mldelibero/roboCooler/README.md

# roboCooler

The compiler used is Keil UV5, which can be downloaded at: 
https://www.keil.com/demo/eval/arm.htm

This project is targeted at the STM32F4DISCOVERY developement kit.
http://www.st.com/web/catalog/tools/FM116/CL1620/SC959/SS1532/LN1848/PF252419?s_searchtype=partnumber

You can find the USB driver for the board there if it doesn't install automatically.

In order to compile the code, open up Keil and press F7 or click Project->Build Target

In order to download the code to the board click Flash->Download
