mldelibero/roboCooler/dwg/roboCoolerBOM.xlsx

Item | Mfg | Mfg P/N | Description | RefDes | Qnty | Vendor | Vendor P/N | Cost | Total Cost | $51.80
1 | Panasonic | EEE-1EA101XP | 100µF Aluminum Capacitor Polar 25V Surface Mount Radial, Can - SMD ±20% -40°C ~ 85°C | C1-C4 | 4 | Digikey | PCE3898TR-ND | $0.12 | $0.48
2 | TDK | C2012X7R2A103K085AA | 10000pF ±10% 100V X7R Ceramic Capacitor -55°C ~ 125°C Surface Mount, MLCC 0805 (2012 Metric) 0.079" L x 0.049" W (2.00mm x 1.25mm) | C5 C6 C17 C18 | 4 | Digikey | 445-1343-1-ND | 0.11 | $0.44
3 | TDK | C2012X7R2A104K125AA | 0.10µF ±10% 100V X7R Ceramic Capacitor -55°C ~ 125°C Surface Mount, MLCC 0805 (2012 Metric) 0.079" L x 0.049" W (2.00mm x 1.25mm) | C8 | 1 | Digikey | 445-1418-1-ND | 0.18 | $0.18
4 | TDK | C2012X7R1E105K125AB | 1µF ±10% 25V X7R Ceramic Capacitor -55°C ~ 125°C Surface Mount, MLCC 0805 (2012 Metric) 0.079" L x 0.049" W (2.00mm x 1.25mm) | C9 C10 C19 | 3 | Digikey | 445-1354-1-ND | 0.14 | $0.42
5 | TDK | C2012X7R1E224M | 0.22µF ±20% 25V X7R Ceramic Capacitor -55°C ~ 125°C Surface Mount, MLCC 0805 (2012 Metric) 0.079" L x 0.049" W (2.00mm x 1.25mm) | C13-C15 | 3 | Digikey | 445-7561-1-ND | 0.14 | $0.42
6 | TDK | C2012X5R1E106K125AB | 10µF ±10% 25V X5R Ceramic Capacitor -55°C ~ 85°C Surface Mount, MLCC 0805 (2012 Metric) 0.079" L x 0.049" W (2.00mm x 1.25mm) | C16 | 1 | Digikey | 445-5984-1-ND | 0.35 | $0.35
7 | Micro Commercial | BAT42W-TP | DIODE SCHOTTKY 30V 200MA SOD123 | D1 D2 | 2 | Digikey | BAT42WTPMSCT-ND (http://www.digikey.com/product-search/en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) | $0.40 | $0.80
8 | Keystone | 3568 | Fuse Holder | F1 F2 | 2 | Digikey | 36-3568-ND | $0.98 | $1.96
9 | LittleFuse | 0297004.WXNV | 4A Fuse Mini-ATO | F1 F2 | 2 | Digikey | F988-ND | $0.47 | $0.94
10 | On Shore Tech | EDZ950/2 | 2 Position Terminal Block Plug, Female Sockets 0.200" (5.08mm) 180° Free Hanging (In-Line) | J1 J2 | 2 | Digikey | ED1717-ND | $1.34 | $2.68
11 | On Shore Tech | EDSTLZ950/2 | 2 Position Terminal Block Header, Male Pins, Shrouded (4 Side) 0.200" (5.08mm) 90°, Right Angle Through Hole | J1 J2 | 2 | Digikey | ED1817-ND | $0.55 | $1.10
12 | 3M | SFH11-PBPC-D25-ST-BK | 50 Position Header Connector 0.100" (2.54mm) Through Hole Gold | J3 J6 | 2 | Digikey | S9201-ND (http://www.digikey.com/product-search/en?x=-787&y=-73&lang=en&site=us&KeyWords=S9201-ND) | $2.89 | $5.78
13 | Sullins | PPPC061LFBN-RC | 6 Position Header Connector 0.100" (2.54mm) Through Hole Gold | J4 | 1 | Digikey | S7039-ND | 0.7 | $0.70
14 | Sullins | PPPC121LFBN-RC | 12 Position Header Connector 0.100" (2.54mm) Through Hole Gold | J5 | 1 | Digikey | S7045-ND | 1.01 | $1.01
15 | Molex | 901303206 | 6 Positions Header, Shrouded Connector 0.100" (2.54mm) Through Hole, Right Angle Gold | J7 J8 J10 J11 J13 J14 | 6 | Digikey | WM8275-ND (http://www.digikey.com/product-detail/en/molex-llc/0901303206/WM8275-ND/760987) | 1.55 | $9.30
16 | Molex | 901420006 | CONN HOUSING 6POS .100" DUAL | P7 P8 P10 P11 P13 P14 | 6 | Digikey | WM8035-ND | 0.43 | $2.58
17 | Molex | 901190110 | Socket Contact Gold 22-24 AWG Crimp | P7 P8 P10 P11 P13 P14 | 36 | Digikey | WM2580CT-ND | 0.22 | $7.92
18 | Assmann | AU-Y1005 | USB Connector | J12 | 1 | Digikey | AE11181-ND | $0.63 | $0.63
19 | Panasonic | ERJ-6ENF1002V | RES SMD 10K OHM 1% 1/8W 0805 | R1 R2 R8-R11 | 6 | Digikey | P10.0KCCT-ND | $0.10 | $0.60
20 | Panasonic | ERJ-6ENF1001V | RES SMD 1K OHM 1% 1/8W 0805 | R5-R7 | 3 | Digikey | P1.00KCCT-ND | $0.10 | $0.30
21 | Fairchild | FDD8878 | MOSFET N-CH 30V 40A DPAK | Q1 Q2 | 2 | Digikey | FDD8878CT-ND | $0.78 | $1.56
22 | Ti | SN74LVC1G04QDBVRQ1 | IC SINGLE INVERTER GATE SOT23-5 | U1 | 1 | Digikey | 296-26588-1-ND (http://www.digikey.com/product-search/en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) | $0.49 | $0.49
23 | Toshiba | TB6549FG(O,EL) | IC MOTOR DRIVER PAR 20HSOP | U2 | 1 | Digikey | TB6549FGOELCT-ND | $4.33 | $4.33
24 | E-Switch | TL3342F160QG/TR | SWITCH TACTILE SPST-NO 0.05A 12V |  | 1 | Digikey | EG2531CT-ND | $0.63 | $0.63
25 | 5V Switcher | OKY-T/3-D12N-C | Non-Isolated PoL Module DC DC Converter 1 Output 0.75 ~ 5.5 V 3A 8.3V - 14V Input | U4 | 1 | Digikey | 811-1990-1-ND | $6.20 | $6.20
