mldelibero/roboCooler/dwg/roboCooler.kicad_pcb

## KiCad design dwg/roboCooler.kicad_pcb (2017-06-04)

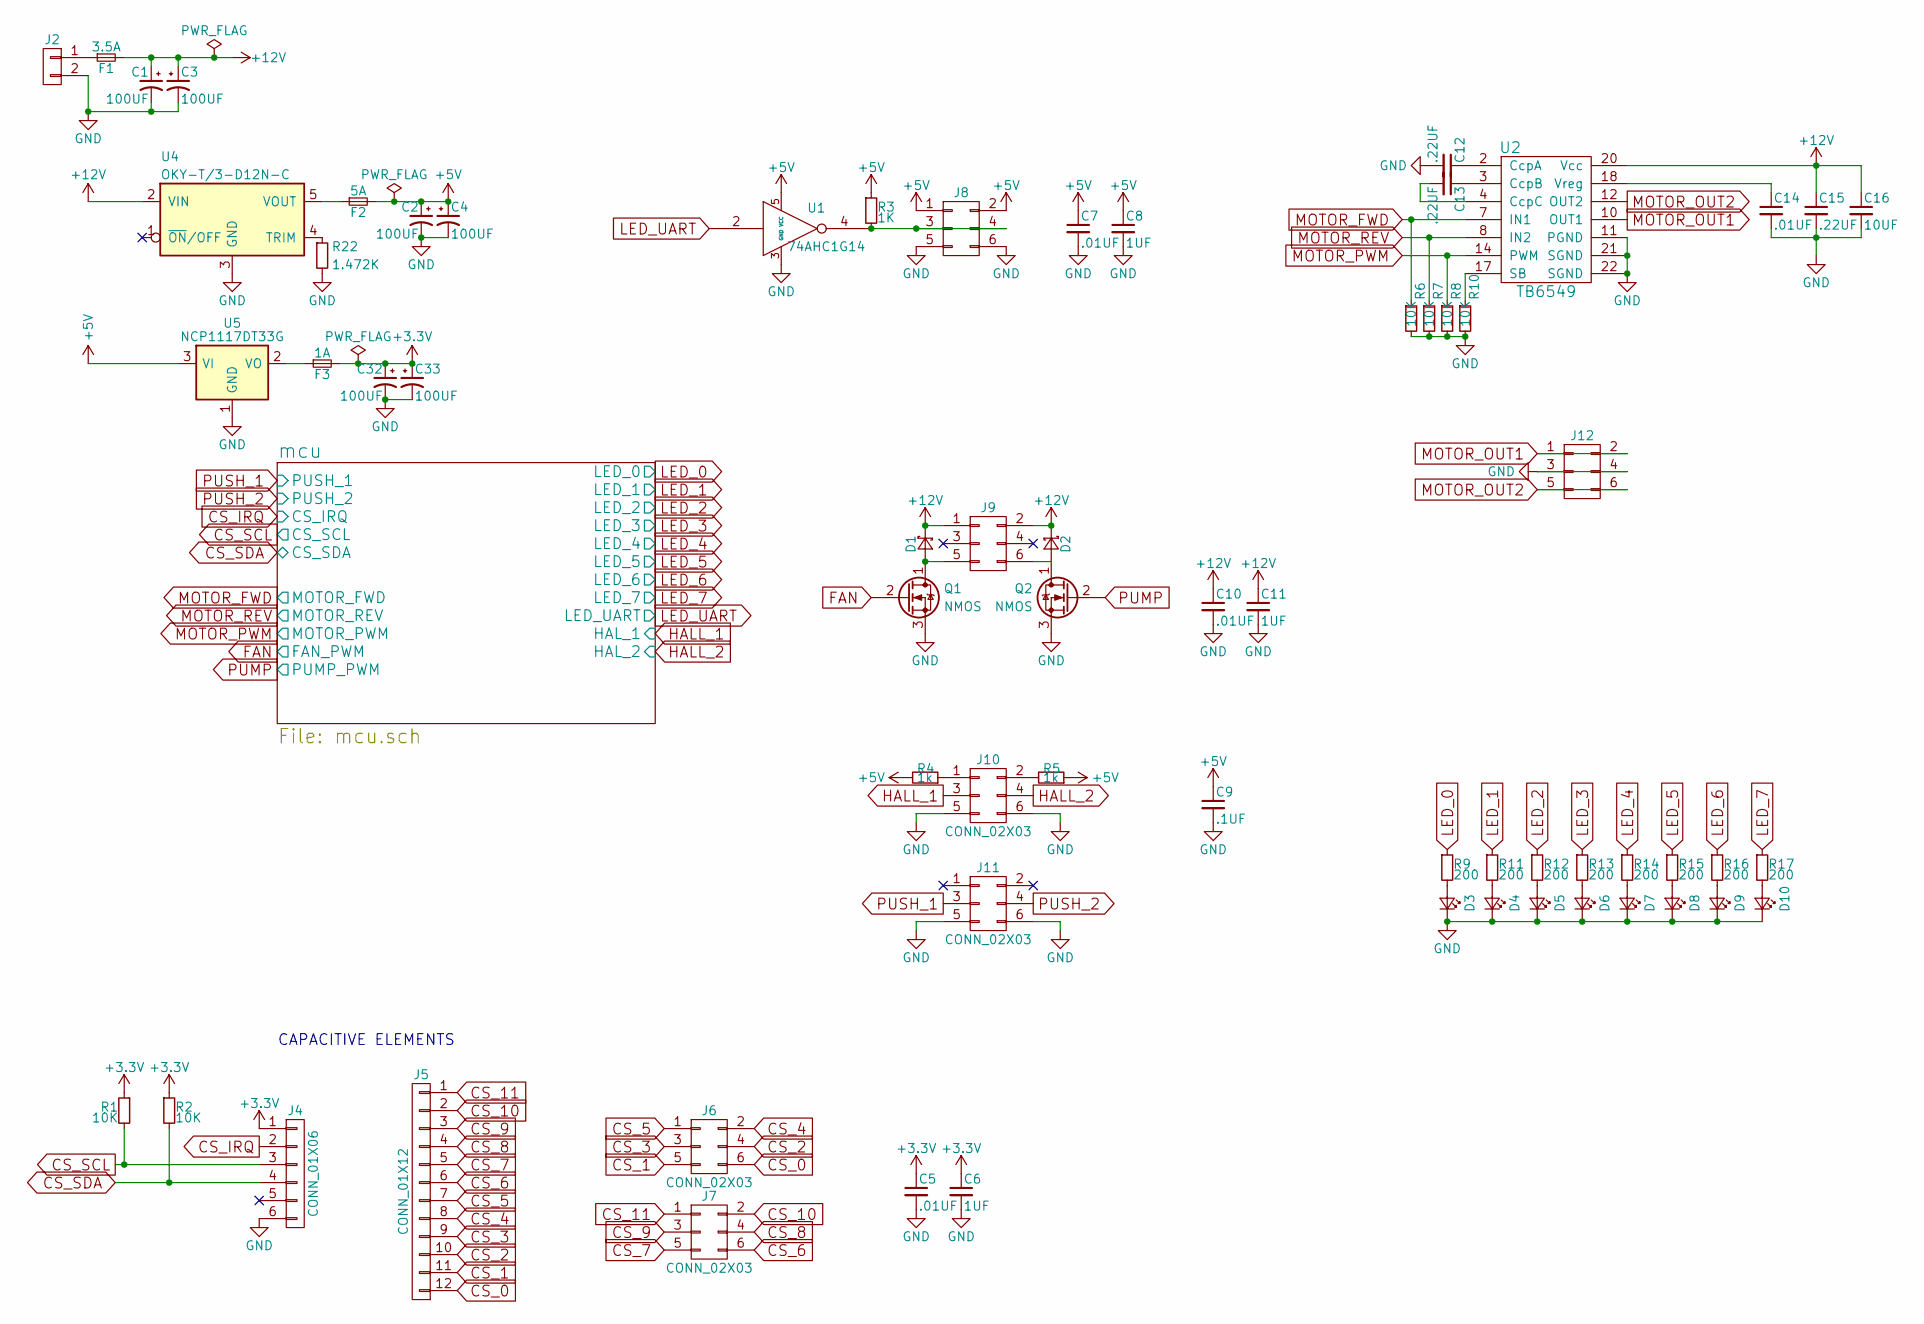
[picture p1: schematic roboCooler.sch]

Parts:
C1, C2, C3, C4, C32, C33: 100UF; c_elec_6.6x6.6
C5, C7, C10, C14: .01UF; C_0603_HandSoldering
C6, C8, C11: 1UF; C_0603_HandSoldering
C9: .1UF; C_0603_HandSoldering
C12, C13, C15: .22UF; C_0603_HandSoldering
C16: 10UF; C_0603_HandSoldering
D1, D2: BAT42; SOD-123
D3, D4, D5, D6, D7, D8, D9, D10: LED_Small; D_0805
F1: 3.5A; R_0603_HandSoldering
F2: 5A; R_0603_HandSoldering
F3: 1A; R_0603_HandSoldering
J2: CONN_01X02; OnShore_EDST_02x01_5.08mm_90Deg
J4: CONN_01X06; Socket_Strip_Straight_1x06
J5: CONN_01X12; Socket_Strip_Straight_1x12
J6, J7, J8, J9, J10, J11, J12: CONN_02X03; Molex_CGridIII_02x03_2.54mm
Q1, Q2: NMOS; TO-252-2Lead
R1, R2, R6, R7, R8, R10: 10K; R_0603_HandSoldering
R3: 1K; R_0603_HandSoldering
R4, R5: 1k; R_0603_HandSoldering
R9, R11, R12, R13, R14, R15, R16, R17: 200; R_0603_HandSoldering
R22: 1.472K; R_0603_HandSoldering
U1: 74AHC1G14; SOT-23-5
U2: TB6549
U4: OKY-T/3-D12N-C; OKY-T3
U5: NCP1117DT33G; TO-252-2

Connections:
+3V3: C5.1, C6.1, C32.1, C33.1, F3.2, J4.1, R1.1, R2.1; also elsewhere on the board
+5V: C2.1, C4.1, C7.1, C8.1, C9.1, F2.2, J8.1, J8.2, R3.1, R4.2, R5.1, U1.5 (VCC), U5.3 (VI)
+12V: C1.1, C3.1, C10.1, C11.1, C15.1, C16.1, D1.1 (K), D2.1 (K), F1.2, J9.1, J9.2, U2.20 (Vcc), U4.2 (VIN)
CS_0: J5.12, J6.6
CS_1: J5.11, J6.5
CS_2: J5.10, J6.4
CS_3: J5.9, J6.3
CS_4: J5.8, J6.2
CS_5: J5.7, J6.1
CS_6: J5.6, J7.6
CS_7: J5.5, J7.5
CS_8: J5.4, J7.4
CS_9: J5.3, J7.3
CS_10: J5.2, J7.2
CS_11: J5.1, J7.1
CS_IRQ: J4.2; also elsewhere on the board
CS_SCL: J4.3, R1.2; also elsewhere on the board
CS_SDA: J4.4, R2.2; also elsewhere on the board
FAN: Q1.2 (G); also elsewhere on the board
GND: C1.2, C2.2, C3.2, C4.2, C5.2, C6.2, C7.2, C8.2, C9.2, C10.2, C11.2, C12.2, C14.2, C15.2, C16.2, C32.2, C33.2, D3.1 (K), D4.1 (K), D5.1 (K), D6.1 (K), D7.1 (K), D8.1 (K), D9.1 (K), D10.1 (K), J2.2, J4.6, J8.5, J8.6, J10.5, J10.6, J11.5, J11.6, J12.3, J12.4, Q1.3 (S), Q2.3 (S), R6.2, R7.2, R8.2, R10.2, R22.2, U1.3 (GND), U2.11 (PGND), U2.21 (SGND), U2.22 (SGND), U4.3 (GND), U5.1 (GND); also elsewhere on the board
HALL_1: J10.3; also elsewhere on the board
HALL_2: J10.4; also elsewhere on the board
LED_0: R9.1; also elsewhere on the board
LED_1: R11.1; also elsewhere on the board
LED_2: R12.1; also elsewhere on the board
LED_3: R13.1; also elsewhere on the board
LED_4: R14.1; also elsewhere on the board
LED_5: R15.1; also elsewhere on the board
LED_6: R16.1; also elsewhere on the board
LED_7: R17.1; also elsewhere on the board
LED_UART: U1.2; also elsewhere on the board
MOTOR_FWD: R6.1, U2.7 (IN1); also elsewhere on the board
MOTOR_OUT1: J12.1, J12.2, U2.10 (OUT1)
MOTOR_OUT2: J12.5, J12.6, U2.12 (OUT2)
MOTOR_PWM: R8.1, U2.14 (PWM); also elsewhere on the board
MOTOR_REV: R7.1, U2.8 (IN2); also elsewhere on the board
unnamed: C12.1, U2.2 (CcpA)
unnamed: C13.1, U2.3 (CcpB)
unnamed: C13.2, U2.4 (CcpC)
unnamed: C14.1, U2.18 (Vreg)
unnamed: D1.2 (A), J9.5, Q1.1 (D)
unnamed: D2.2 (A), J9.6, Q2.1 (D)
unnamed: D3.2 (A), R9.2
unnamed: D4.2 (A), R11.2
unnamed: D5.2 (A), R12.2
unnamed: D6.2 (A), R13.2
unnamed: D7.2 (A), R14.2
unnamed: D8.2 (A), R15.2
unnamed: D9.2 (A), R16.2
unnamed: D10.2 (A), R17.2
unnamed: F1.1, J2.1
unnamed: F2.1, U4.5 (VOUT)
unnamed: F3.1, U5.2 (VO)
unnamed: J8.3, J8.4, R3.2, U1.4
unnamed: J10.1, R4.1
unnamed: J10.2, R5.2
unnamed: R10.1, U2.17 (SB)
unnamed: R22.1, U4.4 (TRIM)
PUMP: Q2.2 (G); also elsewhere on the board
PUSH_1: J11.3; also elsewhere on the board
PUSH_2: J11.4; also elsewhere on the board

Notes on the sheet:
CAPACITIVE ELEMENTS

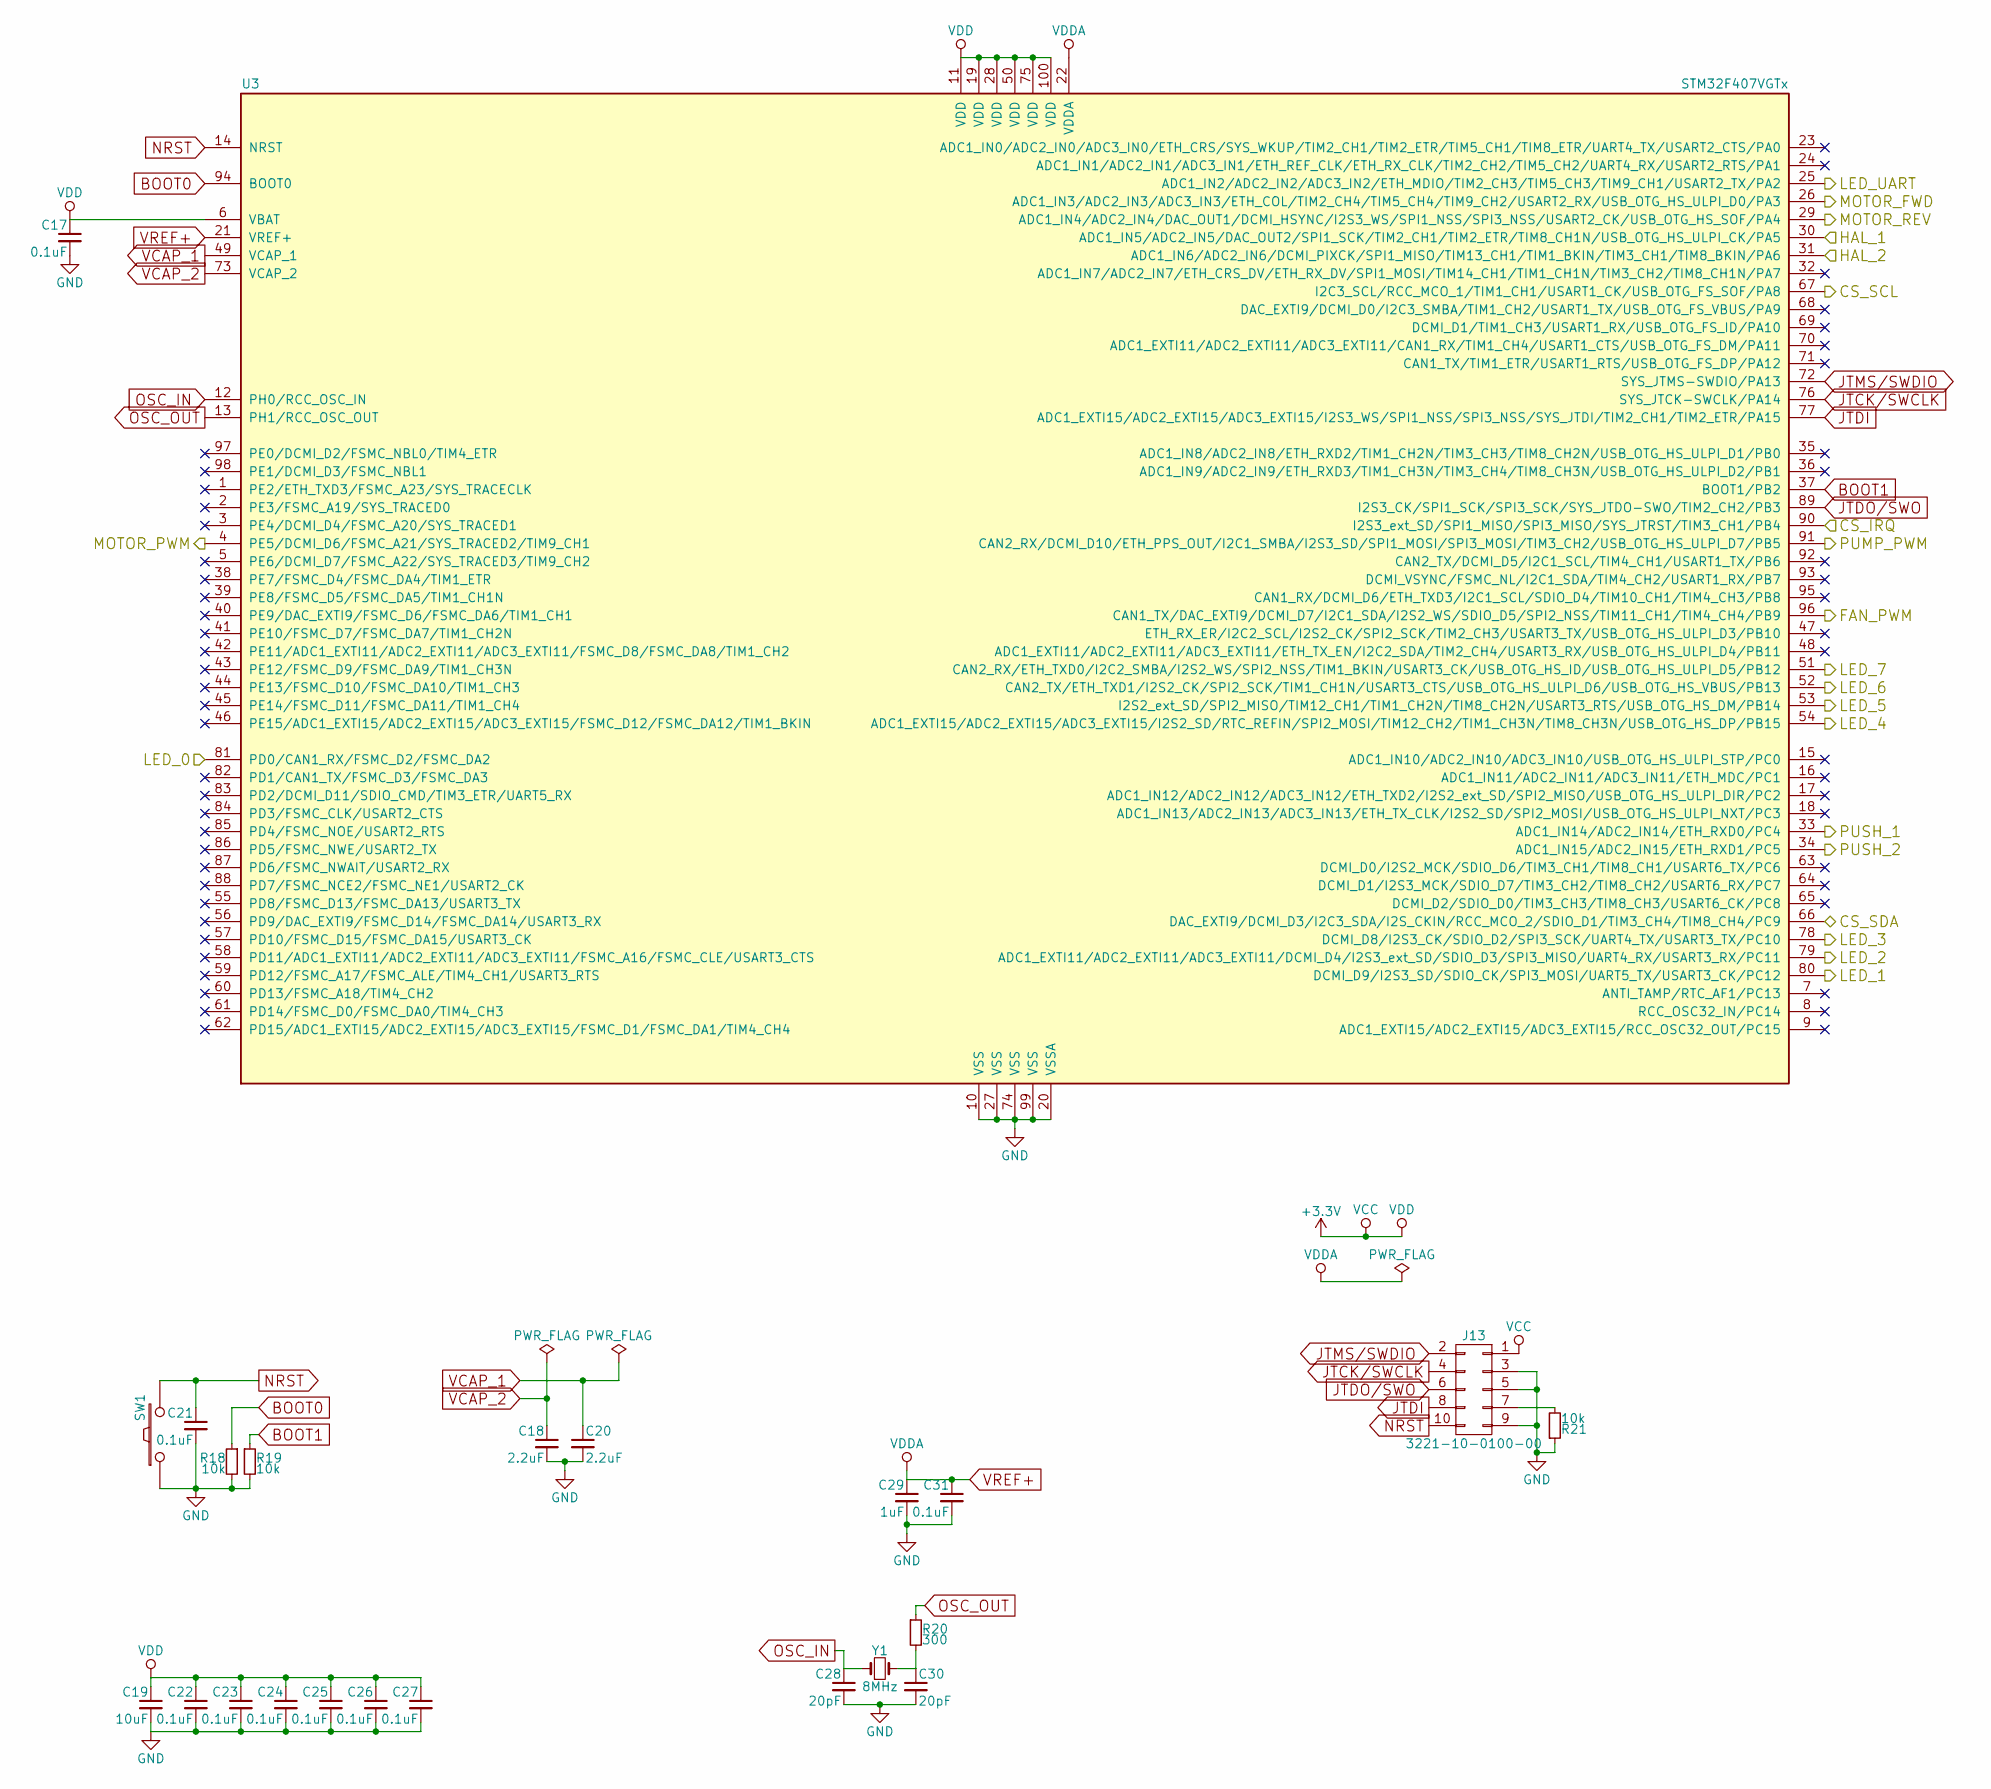
[picture p2: schematic mcu.sch]

Parts:
C17, C21, C22, C23, C24, C25, C26, C27, C31: 0.1uF; C_0603_HandSoldering
C18, C20: 2.2uF; C_0603_HandSoldering
C19: 10uF; C_0603_HandSoldering
C28, C30: 20pF; C_0603_HandSoldering
C29: 1uF; C_0603_HandSoldering
J13: 3221-10-0100-00; Header_02x05_50mil
R18, R19, R21: 10k; R_0603_HandSoldering
R20: 300; R_0603_HandSoldering
SW1: TL3342; SW_SPST_TL3342
U3: STM32F407VGTx; LQFP-100_14x14mm_Pitch0.5mm
Y1: 8MHz; Crystal_SMD_Abracon_ABM3-2pin_5.0x3.2mm_HandSoldering; Part Number ABM3-8.000MHZ-D2Y-T

Connections:
+3V3: C17.1, C19.1, C22.1, C23.1, C24.1, C25.1, C26.1, C27.1, J13.1, U3.6 (VBAT), U3.11 (VDD), U3.19 (VDD), U3.28 (VDD), U3.50 (VDD), U3.75 (VDD), U3.100 (VDD); also elsewhere on the board
BOOT0: R18.1, U3.94 (BOOT0)
BOOT1: R19.1, U3.37 (BOOT1/PB2)
CS_IRQ: U3.90 (I2S3_ext_SD/SPI1_MISO/SPI3_MISO/SYS_JTR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); also elsewhere on the board
CS_SCL: U3.67 (I2C3_SCL/RCC_MCO_1/TIM1_CH1/USART1_CK/U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); also elsewhere on the board
CS_SDA: U3.66 (DAC_EXTI9/DCMI_D3/I2C3_SDA/I2S_CKIN/RCC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); also elsewhere on the board
FAN: U3.96 (CAN1_TX/DAC_EXTI9/DCMI_D7/I2C1_SDA/I2S2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); also elsewhere on the board
GND: C17.2, C18.2, C19.2, C20.2, C21.2, C22.2, C23.2, C24.2, C25.2, C26.2, C27.2, C28.2, C29.2, C30.2, C31.2, J13.3, J13.5, J13.9, R18.2, R19.2, R21.1, SW1.1, U3.10 (VSS), U3.20 (VSSA), U3.27 (VSS), U3.74 (VSS), U3.99 (VSS); also elsewhere on the board
HALL_1: U3.30 (ADC1_IN5/ADC2_IN5/DAC_OUT2/SPI1_SCK/TIM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); also elsewhere on the board
HALL_2: U3.31 (ADC1_IN6/ADC2_IN6/DCMI_PIXCK/SPI1_MISO/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); also elsewhere on the board
JTCK/SWCLK: J13.4, U3.76 (SYS_JTCK-SWCLK/PA14)
JTDI: J13.8, U3.77 (ADC1_EXTI15/ADC2_EXTI15/ADC3_EXTI15/I2S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)
JTDO/SWO: J13.6, U3.89 (I2S3_CK/SPI1_SCK/SPI3_SCK/SYS_JTDO-SWO/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)
JTMS/SWDIO: J13.2, U3.72 (SYS_JTMS-SWDIO/PA13)
LED_0: U3.81 (PD0/CAN1_RX/FSMC_D2/FSMC_DA2); also elsewhere on the board
LED_1: U3.80 (DCMI_D9/I2S3_SD/SDIO_CK/SPI3_MOSI/UART5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); also elsewhere on the board
LED_2: U3.79 (ADC1_EXTI11/ADC2_EXTI11/ADC3_EXTI11/DCM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); also elsewhere on the board
LED_3: U3.78 (DCMI_D8/I2S3_CK/SDIO_D2/SPI3_SCK/UART4_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); also elsewhere on the board
LED_4: U3.54 (ADC1_EXTI15/ADC2_EXTI15/ADC3_EXTI15/I2S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); also elsewhere on the board
LED_5: U3.53 (I2S2_ext_SD/SPI2_MISO/TIM12_CH1/TIM1_CH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); also elsewhere on the board
LED_6: U3.52 (CAN2_TX/ETH_TXD1/I2S2_CK/SPI2_SCK/TIM1_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); also elsewhere on the board
LED_7: U3.51 (CAN2_RX/ETH_TXD0/I2C2_SMBA/I2S2_WS/SPI2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); also elsewhere on the board
LED_UART: U3.25 (ADC1_IN2/ADC2_IN2/ADC3_IN2/ETH_MDIO/TIM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); also elsewhere on the board
MOTOR_FWD: U3.26 (ADC1_IN3/ADC2_IN3/ADC3_IN3/ETH_COL/TIM2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); also elsewhere on the board
MOTOR_PWM: U3.4 (PE5/DCMI_D6/FSMC_A21/SYS_TRACED2/TIM9_C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); also elsewhere on the board
MOTOR_REV: U3.29 (ADC1_IN4/ADC2_IN4/DAC_OUT1/DCMI_HSYNC/I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); also elsewhere on the board
NRST: C21.1, J13.10, SW1.2, U3.14 (NRST)
unnamed: C30.1, R20.2, Y1.2
unnamed: J13.7, R21.2
OSC_IN: C28.1, U3.12 (PH0/RCC_OSC_IN), Y1.1
OSC_OUT: R20.1, U3.13 (PH1/RCC_OSC_OUT)
PUMP: U3.91 (CAN2_RX/DCMI_D10/ETH_PPS_OUT/I2C1_SMBA/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); also elsewhere on the board
PUSH_1: U3.33 (ADC1_IN14/ADC2_IN14/ETH_RXD0/PC4); also elsewhere on the board
PUSH_2: U3.34 (ADC1_IN15/ADC2_IN15/ETH_RXD1/PC5); also elsewhere on the board
VCAP_1: C20.1, U3.49 (VCAP_1)
VCAP_2: C18.1, U3.73 (VCAP_2)
VREF+: C29.1, C31.1, U3.21 (VREF+), U3.22 (VDDA)

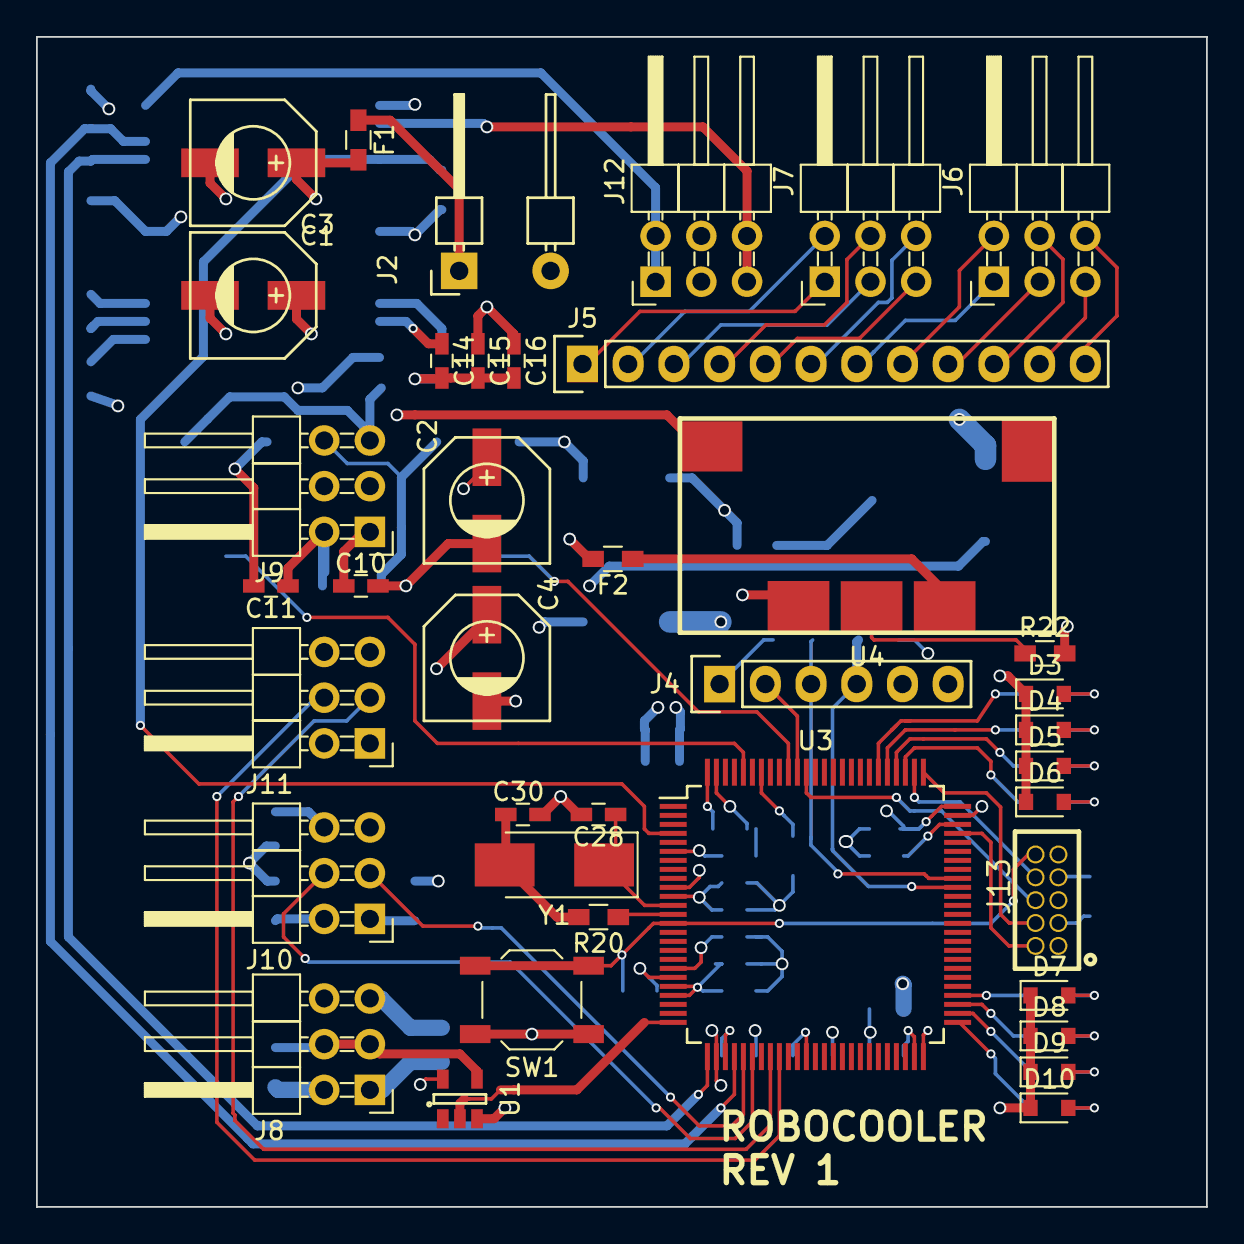
[picture p3: board roboCooler.kicad_pcb from above]

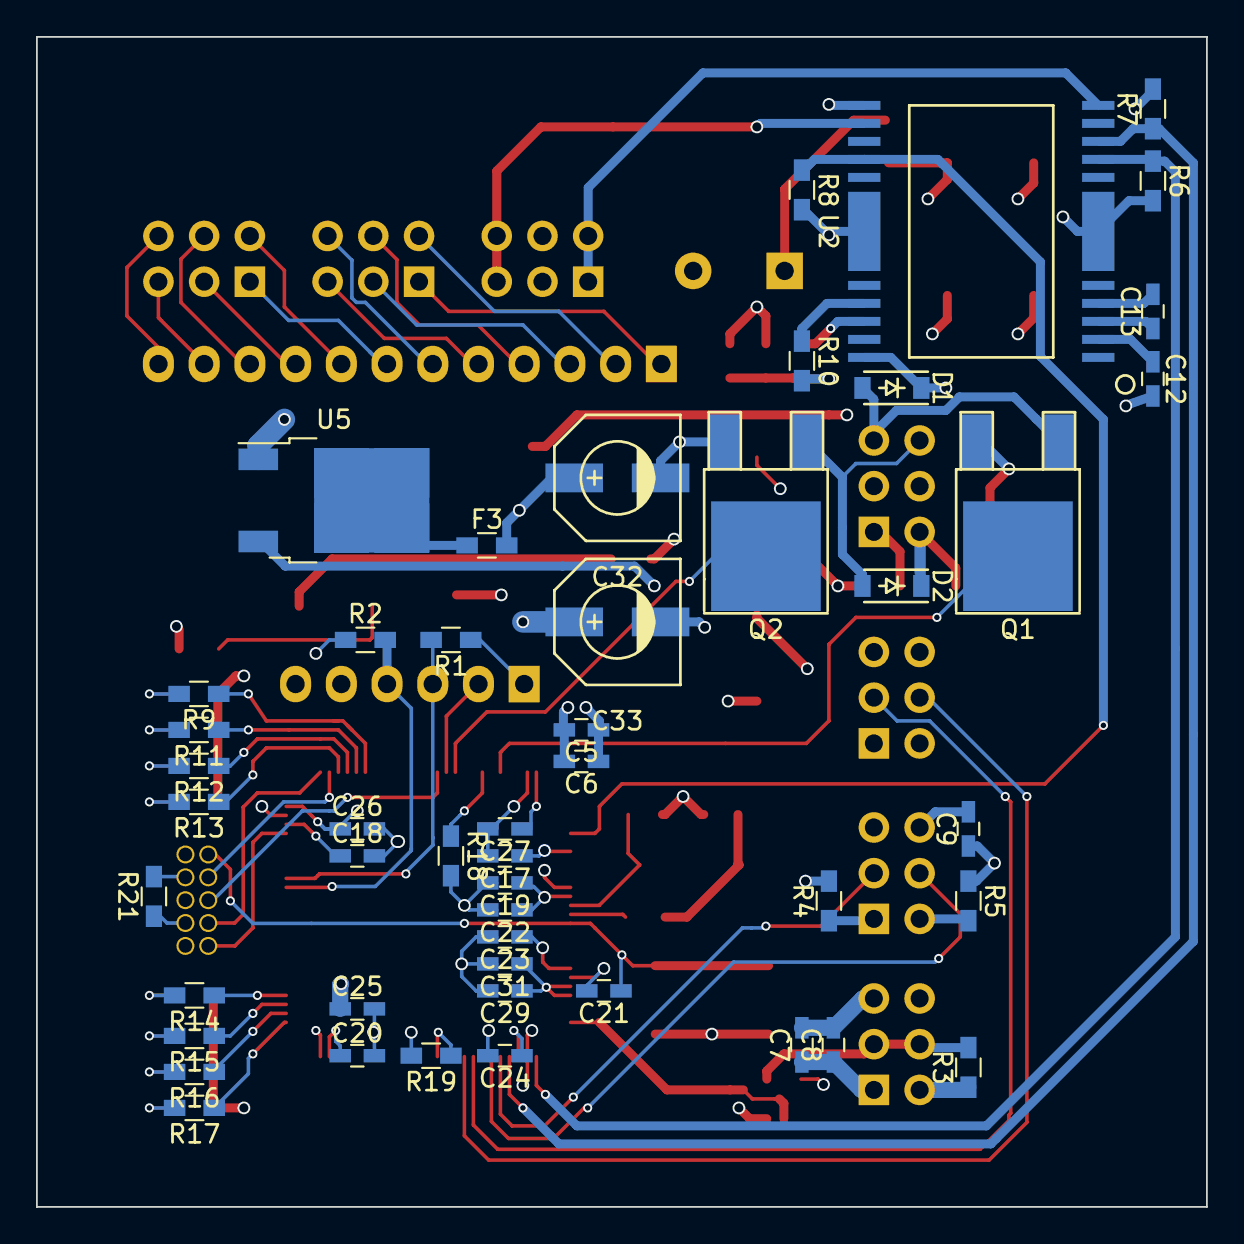
[picture p4: board roboCooler.kicad_pcb from below]

Board: 4 copper layers, 65.0 x 65.0 mm, 88 parts (49 on the bottom side), 75 nets.
