mldelibero/roboCooler/code/src/drivers/capTouchDriver.h

#ifndef __CAP_TOUCH_DRIVER_H
#define __CAP_TOUCH_DRIVER_H
#include <stm32f4xx_hal.h>
#include "CDriver.h"
#include <Driver_I2C.h>

#define PROX_STATUS_BIT 0X1000 // in ELE Touch Status Register -- 1 indicates a touch is detected

class CCapTouchDriver : CDriver
{
    public:
        CCapTouchDriver(GPIO_TypeDef* IRQ_GPIOx, uint16_t IRQ_GPIO_PIN_x, ARM_DRIVER_I2C* Driver_I2Cn);
        virtual ~CCapTouchDriver(void);

        virtual void    Initialize_Hardware(void);
        virtual bool    Is_DataReady(void);
        virtual uint8_t Read(uint8_t reg);
        virtual void    Write(uint8_t reg, uint8_t val);

    protected:
        ARM_DRIVER_I2C* m_Driver_I2Cn;
        uint16_t        m_SlaveAddr;
        GPIO_TypeDef*   m_IRQ_GPIOx;
        uint16_t        m_IRQ_GPIO_PIN_x;
}; // end -- class CCapTouchDriver
#endif //#ifndef __CAP_TOUCH_DRIVER_H
