mldelibero/roboCooler/code/src/drivers/roboCooler.h

/**
  ******************************************************************************
  * @file    roboCooler.h
  * @author  Michael DeLibero
  * @brief   ...
  ******************************************************************************
  */
#ifndef __ROBOCOOLER_H
#define __ROBOCOOLER_H
#include "stm32f4xx_hal.h"
#include <Driver_I2C.h>
#include <Driver_USART.h>

// Limit Switch Driver ---------------------------
// PE6
#define OPEN_LIMSW_GPIOx                     GPIOE
#define OPEN_LIMSW_GPIO_PIN_X                GPIO_PIN_6

// PE4
#define CLOSE_LIMSW_GPIOx                    GPIOE
#define CLOSE_LIMSW_GPIO_PIN_X               GPIO_PIN_5

// Led Strip Driver ------------------------------
extern ARM_DRIVER_USART Driver_USART6;
#define RTE_USART6_TX_DMA               1
#define RTE_USART6_TX_DMA_NUMBER        2
#define RTE_USART6_TX_DMA_STREAM        6
#define RTE_USART6_TX_DMA_CHANNEL       5
#define RTE_USART6_TX_DMA_PRIORITY      1
#define RTE_USART6_TX_ID                2 // PC6
#define LED_Driver_USARTn               Driver_USART6

// Cap Touch Driver ------------------------------
extern ARM_DRIVER_I2C Driver_I2C1;
#define RTE_I2C1                        1
#define RTE_I2C1_SCL_PORT_ID            1 // PB6
#define RTE_I2C1_SDA_PORT_ID            0 // PB8
#define CAP_DRIVER_I2Cn                 Driver_I2C1

#define CAP_IRQ_RCC_AHB1Periph_GPIOx    RCC_AHB1Periph_GPIOA
#define CAP_IRQ_GPIOx                   GPIOA
#define CAP_IRQ_GPIO_PIN_x              GPIO_PIN_1

// Push Button Driver ----------------------------
// PE15
#define PBUP_CLK_ENABLE               __HAL_RCC_GPIOE_CLK_ENABLE
#define PBUP_GPIOx                    GPIOE
#define PBUP_GPIO_PIN_X               GPIO_PIN_15

// PD11
#define PBDN_CLK_ENABLE               __HAL_RCC_GPIOD_CLK_ENABLE
#define PBDN_GPIOx                    GPIOD
#define PBDN_GPIO_PIN_X               GPIO_PIN_11

// Hal Drivers
// PE6
#define Hal1_GPIOn          GPIOE
#define Hal1_GPIO_PIN_n     GPIO_PIN_6

// PE4
#define Hal2_GPIOn          GPIOE
#define Hal2_GPIO_PIN_n     GPIO_PIN_4

#endif // #ifndef __ROBOCOOLER_H
