mldelibero/roboCooler/code/src/leds/ledStrip.cpp

#include "ledStrip.h"
#include "ledStripDriver.h"
#include "component.h"

#include "scene.h"

CLedStripComp::CLedStripComp(CLedStripDriver* LedStripDriver, CScene* FirstScene, CLedObj* LedObjArray) : CComponent(0)
{
    m_LedObjArray    = LedObjArray;
    m_LedStripDriver = LedStripDriver;
    m_NumScenes      = 0; // Gets increased in the Add_Scene function

    this->Add_Scene(FirstScene);
}

void CLedStripComp::Execute(void)
{
    for (int scene = 0; scene < m_NumScenes; scene++)
    {
        m_Scenes[scene]->Play(m_LedObjArray);
    }

    m_LedStripDriver->Update(&m_LedObjArray[0]);
}

void CLedStripComp::Initialize(void)
{
}

uint32_t CLedStripComp::Get_NumberOfScenes(void)
{
    return m_NumScenes;
}

void CLedStripComp::Add_Scene(CScene* NextScene)
{
    if (m_NumScenes < 10)
    {
        m_Scenes[m_NumScenes++] = NextScene;
    }
}
