mldelibero/roboCooler/code/tests/mockFiles/capTouchDriverMock.h

#ifndef __CAP_TOUCH_DRIVER_MOCK_H
#define __CAP_TOUCH_DRIVER_MOCK_H

#include "capTouchDriver.h"
class CCapTouchDriverMock : public CCapTouchDriver
{
    public:
        CCapTouchDriverMock(void);
        ~CCapTouchDriverMock(void);

        void Initialize_Hardware(void);

        void Clear_MockDataReady(void);
        void Set_MockDataReady(void);
        bool Is_DataReady(void);

        void Clear_MockTouchDetected(void);
        void Set_MockTouchDetected(void);
        uint16_t Read(unsigned char address);

    private:
        GPIO_PinState m_MockInputValue;
        bool m_Mock_DataReady;
        bool m_Mock_TouchDetected;
};
#endif // #ifndef __CAP_TOUCH_DRIVER_MOCK_H
