mldelibero/roboCooler/code/tests/Level_2/LedBehaviorTests.h

#ifndef __LEDBEHAVIORTESTS_H
#define __LEDBEHAVIORTESTS_H
#include "ledObj.h"
#define NUM_LEDS             5
void CheckLeds(uint16_t StartIndex, uint16_t EndIndex, uint16_t NumLeds, CLedObj* OutputLedObj, CLedObj InObj, CLedObj OutObj);
#endif //#ifndef __LEDBEHAVIORTESTS_H
