mldelibero/roboCooler/code/tests/mockFiles/holding/ledBehaviorMock.h

#ifndef __LEDBEHAVIORMOCK_H
#define __LEDBEHAVIORMOCK_H
#include "ledBehavior.h"

class CLedBehaviorMock : public CLedBehaviorComp
{
    public:
        CLedBehaviorMock();

        virtual void Execute(void);
        virtual void Initialize(void);

        void Force_Blended(bool isBlended);
        void Force_State(Led_Behavior_t state);
        bool Is_Blended(void);

        bool m_IsBlended;
};
#endif // #ifndef __LEDBEHAVIORMOCK_H
