mldelibero/roboCooler/(commit log)

2010-09-16 updated for pushbuttons
    [crossbar.xlsx]
2015-10-06 added heartbeart led
2015-10-10 Sched is working at 1kHz Heartbeat is working at 1Hz Test toggle is working.
2015-10-24 added libraries for led driver
2015-10-24 added doc for led driver chip
2015-10-24 added leds include
2015-10-24 added leds and library files
2015-10-24 added MWE for LED driver
2015-11-14 updated led driver
2015-11-15 added capacitor sense files
2015-11-15 added crossbar for selecting mcu pins
    [crossbar.xlsx]
2015-11-15 added i2c lib files to be used with the cap sense board
2015-11-18 added capsense i2c and dma files to prj
2015-11-25 Added code to release bus on config. changed read to 16 bits to read all inputs. Fixed nack for read fun. Added all 12 inputs.
    [capsense.cpp]
2015-12-05 added docs for hall sensor
2015-12-05 added pin doc to usart output.
2015-12-05 Added base for lid motor driver.
    [crossbar.xlsx]
2015-12-05 Added funs to turn motor on in both directions and off
2015-12-06 added drawing files for schematic purposes.
    [roboCooler.sch]
2015-12-06 added bom
    [roboCoolerBOM.xlsx]
2015-12-07 moved led to not be on a pin used by the dev kit.
2015-12-07 moved scheduler to tim4 to accomodate conseq timers for the pwm outputs.
2015-12-07 added basic information for all of the connections
    [crossbar.xlsx, roboCooler.sch, roboCoolerBOM.xlsx]
2015-12-19 updated BOM and changed 2 pin conns to 3 pins
    [roboCooler.sch, roboCoolerBOM.xlsx]
2015-12-23 updated hbridge
    [roboCooler.sch, roboCoolerBOM.xlsx]
2016-01-16 moved hbridge to second sheet.
    [hBridge.sch, roboCooler.sch]
2016-01-16 cleaned up hbridge file
    [hBridge.sch]
2016-01-16 added resistors for hbridge optocouplers
    [hBridge.sch]
2016-01-18 Added connectors to BOM
    [hBridge.sch, roboCooler.sch, roboCoolerBOM.xlsx]
2016-02-01 consolidated BOM and fixed some errors before ordering.
    [roboCoolerBOM.xlsx]
2016-02-14 moved lid motor and push button pins
    [crossbar.xlsx, roboCooler.sch]
2016-03-21 created allocation tests for the timer module
2016-03-21 changed from giving timer ptr to timer index
2016-03-21 added ability to set a timer value
2016-04-01 chagned Time to Timer
2016-04-01 added mocks for inital timer driver initialization.
2016-04-02 added files for integration testing of timerDriver
    [crossbar.xlsx]
2016-04-02 updated to use interrupt.
2016-04-02 updated to current source
2016-04-23 updated name for setting up int test of timer driver
2016-04-23 added spreadsheet for power requirements
    [roboCoolerPwrReq.xlsx]
2016-04-23 added tests for integration of timer driver
2016-04-23 added initial tests and code for push buttons.
2016-04-24 passed timer integration test
2016-04-24 moved timer vars to own dir to move out of the way for most testing.
2016-04-24 moved timer tests to own dirs
2016-04-25 added some testing for pb filtering
2016-04-30 combining integration testing of timer driver and timer.
2016-04-30 reserved PE15 for timer integration test output
    [crossbar.xlsx]
2016-04-30 added code to test init fun for timer test
2016-04-30 added test for toggling gpio pin when timer is expired
2016-05-01 added tests for timer isr and isTimerExpired fun.
2016-05-01 removed motor command from pushbutton -- encapsulation
2016-06-19 Added pushbuttons to layout
    [crossbar.xlsx, hBridge.sch, roboCooler.kicad_pcb, roboCooler.sch]
2016-06-19 added cap sense to layout
    [crossbar.xlsx, hBridge.sch, roboCooler.kicad_pcb, roboCooler.sch]
2016-06-19 added pull up resistors to cap sense i2c lines
    [hBridge.sch, roboCooler.kicad_pcb, roboCooler.sch]
2016-06-19 added no connects to mcu connectors
    [crossbar.xlsx, roboCooler.kicad_pcb, roboCooler.sch]
2016-06-19 Added LED USART to layout
    [crossbar.xlsx, hBridge.sch, roboCooler.kicad_pcb, roboCooler.sch, roboCoolerBOM.xlsx]
2016-06-20 added fan driver components to layout
    [crossbar.xlsx, hBridge.sch, roboCooler.kicad_pcb, roboCooler.sch, roboCoolerBOM.xlsx]
2016-06-20 fixed cap sense conn gender footprint
    [roboCooler.kicad_pcb]
2016-06-20 added pump parts to layout
    [crossbar.xlsx, hBridge.sch, roboCooler.kicad_pcb, roboCooler.sch]
2016-06-20 added hall sensors to layout
    [crossbar.xlsx, hBridge.sch, roboCooler.kicad_pcb, roboCooler.sch]
2016-06-21 fixed connector 3d view on board.
    [roboCooler.kicad_pcb, roboCooler.sch]
2016-06-29 added motor driver chip to schematic and removed hbridge
    [crossbar.xlsx, hBridge.sch, roboCooler.sch]
2016-07-03 added footprint for motordriver
2016-07-03 placed components for motor driver
    [roboCooler.kicad_pcb, roboCooler.sch]
2016-07-03 added pull up resistors to hall effect sensors
    [roboCooler.sch]
2016-07-04 updated power estimates
    [roboCoolerPwrReq.xlsx]
2016-07-04 updated power nets on schematic
    [roboCooler.sch]
2016-07-04 updated power entery to baord
    [roboCooler.sch, roboCoolerBOM.xlsx]
2016-07-04 moved crossbar to dwg dir
    [crossbar.xlsx]
2016-07-04 updated crossbar and no-connects
    [crossbar.xlsx, roboCooler.sch]
2016-07-04 synced crossbar with mcu pinout on schematic
    [crossbar.xlsx, roboCooler.sch]
2016-07-04 reclassified TB6549 symbol gnd pins as power inputs
2016-07-04 removed erc errors from schematic
    [roboCooler.kicad_pcb, roboCooler.sch, roboCoolerBOM.xlsx]
2016-07-04 reset layout
    [roboCooler.kicad_pcb, roboCooler.sch]
2016-07-05 Initial part placement on layout complete
    [crossbar.xlsx, roboCooler.kicad_pcb, roboCooler.sch, roboCoolerBOM.xlsx]
2016-07-05 shrunk board by updating component placement
    [roboCooler.kicad_pcb]
2016-07-06 updated BOM
    [roboCooler.kicad_pcb, roboCooler.sch, roboCoolerBOM.xlsx]
2016-07-09 updated conn for capsense out and hal sensors
    [roboCooler.kicad_pcb, roboCooler.sch, roboCoolerBOM.xlsx]
2016-07-09 moved led fan and pump to 6-pin conns
    [roboCooler.kicad_pcb, roboCooler.sch, roboCoolerBOM.xlsx]
2016-07-10 moved all components inside the disc envelope
    [crossbar.xlsx, roboCooler.kicad_pcb, roboCooler.sch, roboCoolerBOM.xlsx]
2016-07-12 updated pcb design rules
    [roboCooler.kicad_pcb]
2016-07-12 added 8 leds
    [crossbar.xlsx, roboCooler.kicad_pcb, roboCooler.sch]
2016-07-12 first pass at layout
    [roboCooler.kicad_pcb, roboCooler.sch]
2016-07-13 increased size of pcb power nets and reordered some components.
    [roboCooler.kicad_pcb]
2016-07-13 increased some track widths on pcb
    [roboCooler.kicad_pcb]
2016-07-14 added mounting holes
    [roboCooler.kicad_pcb]
2016-07-14 increased trace widths for led driver
    [roboCooler.kicad_pcb, roboCooler.sch]
2016-07-17 moved J11 to the same 6pin connector.
    [roboCooler.kicad_pcb, roboCooler.sch, roboCoolerBOM.xlsx]
2016-07-29 removed unused crimp contacts
    [roboCoolerBOM.xlsx]
2016-07-29 tweaked layout before ordering
    [roboCooler.kicad_pcb]
2016-07-29 added board name, rev, & sn to silkscreen
    [roboCooler.kicad_pcb]
2016-08-29 crossbar - updated positions of the leds
    [crossbar.xlsx]
2016-08-29 added ledDriver files
2016-08-29 removed unnecessary ledDriver defines
2016-08-29 added led pin initializations.
2016-08-29 added ledTests
2016-08-29 added test to allocate led timer
2016-08-31 timer mock now looking for correct timer when setting a timer added reset for timer mock added ability to mock allocate a specific timer.
    [timer.cpp]
2016-08-31 now initializing leds
2016-08-31 added leds and timers to prj
2016-08-31 now checking that pushbutton sets the correct timer
    [pushButtonTest.cpp]
2016-08-31 now checking that leds sets the correct timer
    [ledTest.cpp, leds.cpp]
2016-08-31 moved all driver files to src/drivers and fixed compilation errors
    [ledDriver.cpp, ledDriver.h, pushButtonDriver.cpp, timer.cpp, timer.h, timerDriver.cpp, timerDriver.h]
2016-08-31 now keeping track of all mocking all io pins for each GPIOx
2016-09-03 added src & tests to set/clear leds
2016-09-03 timerTest.cpp changed tabs to spaces
2016-09-03 moved push button test out of the way for now.
2016-09-03 timer.cpp -- fixed spacing
    [timer.cpp]
2016-09-03 timer.h -- fixed formatting of include protection hash
    [timer.h]
2016-09-03 moved leds over to use comp class
2016-09-03 leds now update hardware on run
2016-09-04 added mock call to set led gpio values
2016-09-04 added ability for inherited child to set comp reset time
    [component.cpp, component.h]
2016-09-04 added tests for led boot mode operation.
2016-09-10 added rest of testing for leds
2016-09-14 removed depricated scheduler.* files for timer(driver).* files
2016-09-14 started testing the lid motor
2016-09-14 added drivers to makeall
2016-09-14 added lidmotor driver init test
2016-09-14 added def for lidmotor driver to get keil to compile
2016-09-15 lid motor now uses limit switches to determine state
2016-09-16 added code to stop lid at limit switches
2016-09-16 added lid reacting to captouch sensor
2016-09-18 added limit switch initalization to init fun
2016-09-18 added tests for limit switch gpio driver
2016-09-18 testing that limsw driver returns correct output
    [limSwitchDriverTests.cpp]
2016-09-18 moved todo list from limitswith driver to limit switch
2016-09-19 limSwitch samples inputs on run
2016-10-18 moved timer test from Level_2 to Level_1
2016-10-18 removed references to timer
2016-10-18 remvoed function pointer from limit switch
2016-10-18 no longer looking at timer during testing
    [lidMotorTests.cpp]
2016-11-20 added base hardware driver class
2016-11-22 limswDriver -- swapping constructor arguments
    [limSwitchDriverTests.cpp, limitSwitchDriver.cpp, limitSwitchDriver.h]
2016-11-22 limSwDriver -- added sample, removed old funs, & retested init
2016-11-23 now requiring limitswitch to instantiate with a hardware driver object
2016-12-04 moving to use mocks for limSw and driver
2016-12-10 added hysteresis to limit switch
2016-12-10 Now testing that limswithes get sampled in loop
2016-12-10 tests -- testing reset of limsw obj
    [limitSwitchTests.cpp]
2016-12-10 Added cap touch driver with gpio inputs
2016-12-11 added i2c init to capdriver
2016-12-11 added lid motor to main loop
2016-12-12 added driver to capTouch
2016-12-26 added led init
2016-12-26 added sensor inputs to ledstrip component
2016-12-26 added ledstrip driver
2016-12-27 pushed system knowledge from led strip into the individual scenes
2016-12-27 added testing and code outline for complete led strip component
2016-12-27 added code for led objs
2016-12-27 added note for timer upgrade
2016-12-27 led strip comp now always has a timeout of zero
2016-12-27 now testing that we did not use up all available timers in the init function
2016-12-27 scene is no longer derived from component
    [init.cpp, ledStrip.cpp, ledStrip.h, ledStripMock.cpp, scene.h, sceneMock.cpp, sceneMock.h]
2016-12-27 moved led obj array inside of led strip comp
2016-12-27 added initial test framework for a scene obj
2016-12-31 fix ledStripDriver dependency
2017-01-02 Added getting and forcing status of led behavior base class
2017-01-05 initializing behavior resets state
    [LedBehaviorTests.cpp, ledBehavior.cpp]
2017-01-07 ledStrip tells scenes about numLeds and ledObjArray pointer
2017-01-07 scene sends ledobjarray pointer when running behaviors
2017-01-21 moved LED behavior child to a pointer in the test setup
2017-01-21 renamed component timer vars to be more descriptive
2017-01-21 promoted ledbehavior and scene tests b/c ledb is dependent on timer
2017-01-21 using real ledobj class instead of mock b/c it is so simple
2017-01-21 now can set ledbeh numleds
2017-01-21 behaviors can updated led array with no blending
2017-01-22 can operate on a percentage band of the led strip with an led behavior
2017-01-22 moved checking led beh output into a function to be shared between test files
2017-01-22 added solid color led behavior class
2017-01-26 added wrap around test for moving band led behavior
2017-01-28 added test to make sure ledstripdriver is initialized in init fun
2017-01-28 added framework for ledstripdriver tests
2017-01-28 added file calculate led strip driver timing
    [LedDriverTiming.xlsx]
2017-01-29 changed ledObj to use float to store percentages
2017-01-30 moved led strip driver level 2 to be able to use mock timer funs
2017-01-30 Added documentation about logivc for the led strip driver
    [LedEncoding.xlsx]
2017-01-30 added testing for ledStrip driver
2017-02-05 added gpio settings to led strip driver
2017-02-06 added periph pointer conversions to dma driver
2017-03-01 adding hal i2c lib
2017-03-02 updated i2c to hal and commented some out
2017-03-09 commented most code. Moved timer to HAL and toggling pin in isr
2017-03-19 timer operates at the correct frequency
    [init.cpp]
2017-03-22 timerdriver compiles with hal
2017-03-22 tests now compile for ledDriver
2017-03-22 started porting level2 -- ledstripdriver compiles but fails a test
    [LedBehaviorChildrenTests.cpp, LedBehaviorTests.cpp, LedStripDriverTests.cpp, capTouchDriverMock.cpp, capTouchDriverMock.h, capTouchMock.cpp, capTouchMock.h, capTouchTests.cpp]
2017-03-23 ledStripdriver tests now run
2017-03-23 ledtests now run
2017-03-23 led behavior & childred tests now run
2017-03-25 ledstriptests pass
2017-04-01 addded disc board blinky prog and fixed clocks
    [init.cpp, loop.cpp, timer.cpp, timer.h]
2017-04-02 now blinks leds and runs timers
2017-04-22 updated clocks to allow for led strip driver @ 2.7MHz
2017-05-07 temporarily hardcoded to test uart dma
2017-05-08 sucessfull scope test of led driver timing
    [LedDriverTiming.xlsx]
2017-05-13 commit before switching to cmsis
2017-05-13 basic cmsis driver for ledStrip working
2017-05-13 output for led driver correct on scope for cmsis
    [LedDriverTiming.xlsx]
2017-05-13 removed unused HAL code and fixed define in RTE_Device for ledStrip
    [init.cpp, ledStripDriver.cpp]
2017-05-13 capsense i2c started to port to cmsis
2017-05-13 basic i2c driver for capsense ported to cmsis
2017-05-14 started porting lid motor driver to hal
2017-05-15 sample lidMotor output working on scope
2017-05-17 basic test with real motor works. Need to add more bus capacitance
2017-05-17 added basic hal effect sensor driver
2017-05-17 added hall effect driver to prj
2017-05-17 updated to new version of kicad
    [roboCooler.sch]
2017-05-17 added mcu to board.
    [crossbar.xlsx, mcu.sch, roboCooler.sch]
2017-05-21 updating board -- no DRC errors
    [crystal.xlsx, mcu.sch, roboCooler.kicad_pcb, roboCooler.sch, roboCoolerBOM.xlsx]
2017-05-23 updated placement on new board. No DRC errors
    [mcu.sch, roboCooler.kicad_pcb, roboCooler.sch]
2017-05-25 fixed minor typos in hall effect driver
    [halDriver.cpp, halDriver.h]
2017-05-25 added 5V switcher
    [mcu.sch, roboCooler.kicad_pcb, roboCooler.sch, roboCoolerBOM.xlsx]
2017-05-25 added 3.3V LDO
    [mcu.sch, roboCooler.kicad_pcb, roboCooler.sch]
2017-05-28 finished inital component placement
    [roboCooler.kicad_pcb, roboCooler.sch]
2017-06-04 finished first round of routing. no drc errors
    [crossbar.xlsx, mcu.sch, roboCooler.kicad_pcb, roboCooler.sch, roboCoolerPwrReq.xlsx]
